w32agobot/SKY130_SAR-ADC/doc/img/SAR_ADC.png

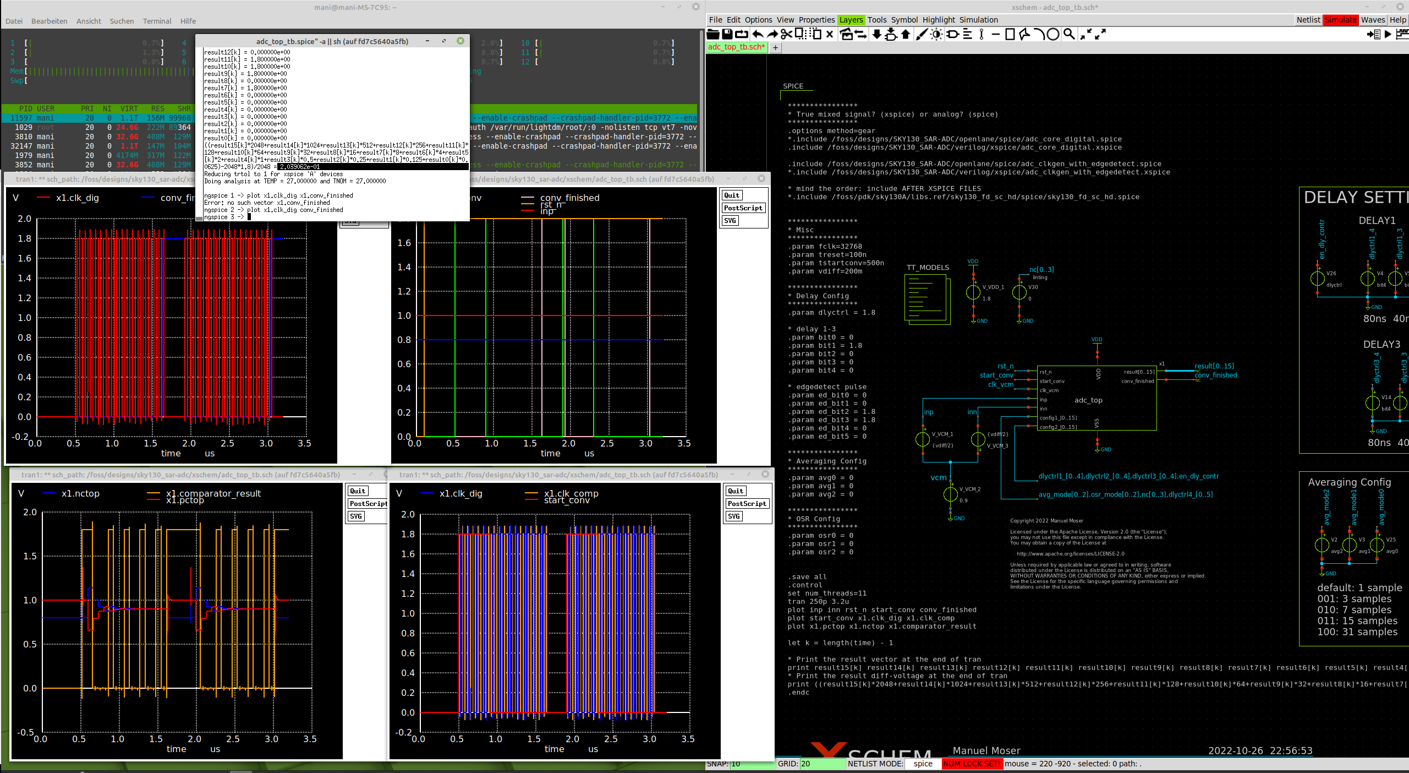
doc/img/SAR_ADC.png
