w32agobot/SKY130_SAR-ADC/doc/img/synth_explore.png

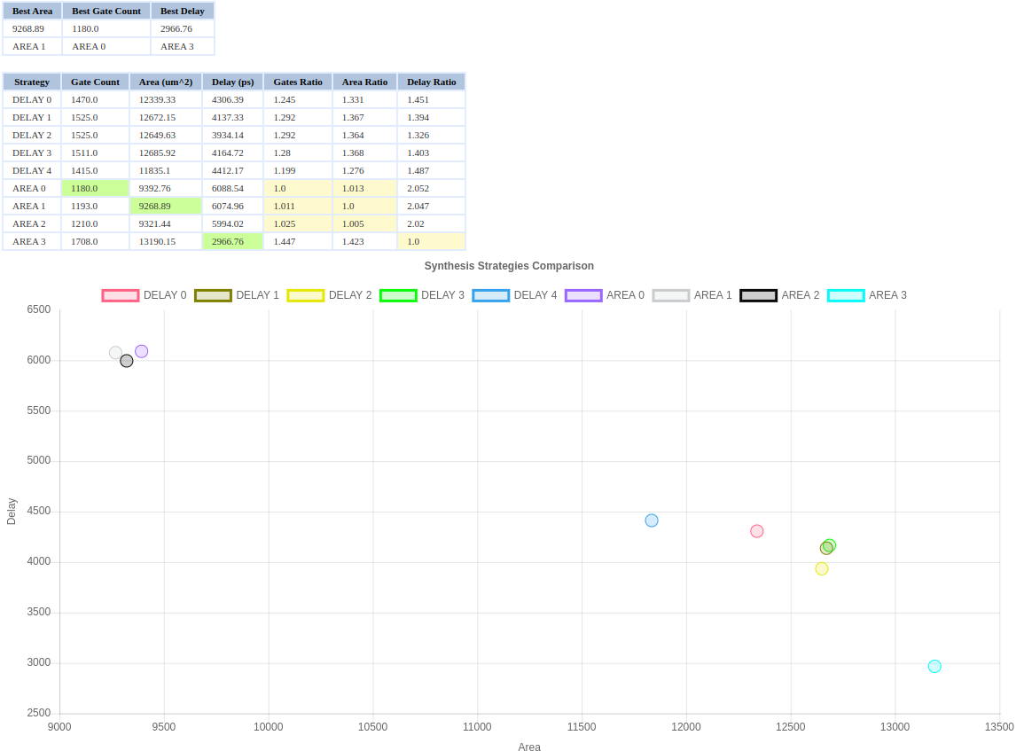
doc/img/synth_explore.png
