w32agobot/SKY130_SAR-ADC/mag/adc_array_topologies/Wafflecap_topA_area-approximation.png

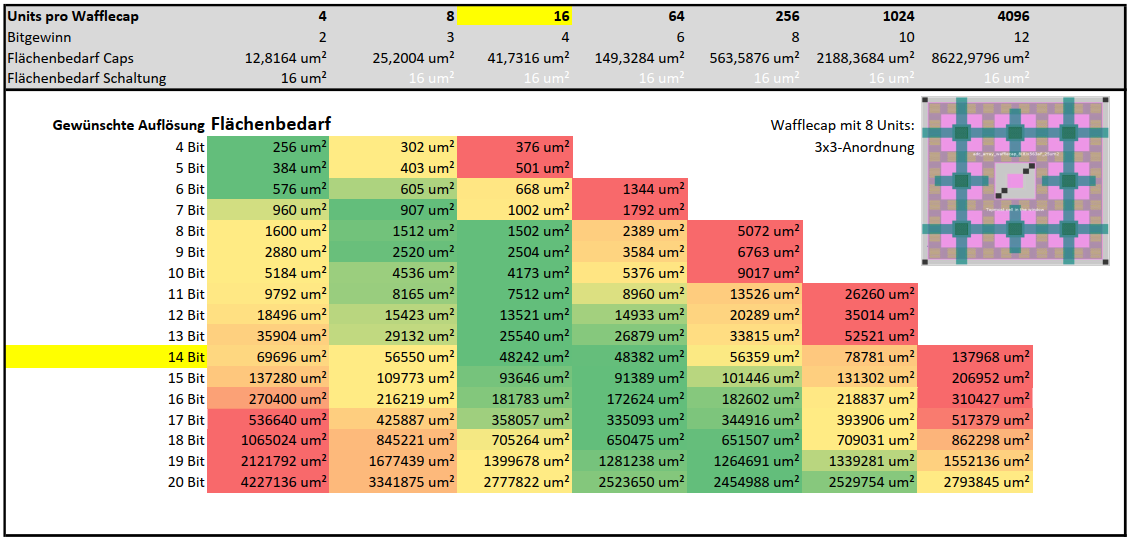
mag/adc_array_topologies/Wafflecap_topA_area-approximation.png
