w32agobot/SKY130_SAR-ADC/archive/openlane/adc_clkgen_with_edgedetect_thermocode/runs/kaiserschmarrn/reports/metrics.csv

design | design_name | config | flow_status | total_runtime | routed_runtime | (Cell/mm^2)/Core_Util | DIEAREA_mm^2 | CellPer_mm^2 | OpenDP_Util | Peak_Memory_Usage_MB | cell_count | tritonRoute_violations | Short_violations | MetSpc_violations | OffGrid_violations | MinHole_violations | Other_violations | Magic_violations | antenna_violations | lvs_total_errors | cvc_total_errors | klayout_violations | wire_length | vias | wns | pl_wns | optimized_wns | fastroute_wns | spef_wns | tns | pl_tns | optimized_tns | fastroute_tns | spef_tns | HPWL | routing_layer1_pct | routing_layer2_pct | routing_layer3_pct | routing_layer4_pct | routing_layer5_pct | routing_layer6_pct | wires_count | wire_bits | public_wires_count | public_wire_bits | memories_count | memory_bits | processes_count | cells_pre_abc | AND | DFF | NAND | NOR | OR | XOR | XNOR | MUX | inputs | outputs
/foss/designs/SKY130_SAR-ADC/openlane/adc_clkgen_with_edgedetect | adc_clkgen_with_edgedetect | kaiserschmarrn | flow completed | 0h14m51s0ms | 0h13m45s0ms | -2.0 | 0.014352 | -1 | 56.32 | 559.75 | -1 | 0 | 0 | 0 | 0 | 0 | 0 | 0 | -1 | -1 | -1 | -1 | 34863 | 6105 | 0.0 | 0.0 | -1 | 0.0 | -1 | 0.0 | 0.0 | -1 | 0.0 | -1 | 8452288.0 | 0.0 | 69.45 | 45.13 | 58.78 | 6.52 | -1 | 404 | 935 | 72 | 603 | 0 | 0 | 0 | 743 | 9 | 0 | 38 | 14 | 99 | 0 | 0 | 0 | 27 | 202
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
