w32agobot/SKY130_SAR-ADC/openlane/adc_clkgen_with_edgedetect_native/runs/Pizza/results/signoff/adc_clkgen_with_edgedetect_native.lef.spice

* NGSPICE file created from adc_clkgen_with_edgedetect_native.ext - technology: sky130A

* Black-box entry subcircuit for sky130_fd_sc_hd__decap_4 abstract view
.subckt sky130_fd_sc_hd__decap_4 VGND VNB VPB VPWR
.ends

* Black-box entry subcircuit for sky130_fd_sc_hd__tapvpwrvgnd_1 abstract view
.subckt sky130_fd_sc_hd__tapvpwrvgnd_1 VGND VPWR
.ends

* Black-box entry subcircuit for sky130_fd_sc_hd__decap_6 abstract view
.subckt sky130_fd_sc_hd__decap_6 VGND VNB VPB VPWR
.ends

* Black-box entry subcircuit for sky130_fd_sc_hd__clkdlybuf4s50_2 abstract view
.subckt sky130_fd_sc_hd__clkdlybuf4s50_2 A VGND VNB VPB VPWR X
.ends

* Black-box entry subcircuit for sky130_fd_sc_hd__decap_8 abstract view
.subckt sky130_fd_sc_hd__decap_8 VGND VNB VPB VPWR
.ends

* Black-box entry subcircuit for sky130_ef_sc_hd__decap_12 abstract view
.subckt sky130_ef_sc_hd__decap_12 VGND VPWR VPB VNB
.ends

* Black-box entry subcircuit for sky130_fd_sc_hd__decap_3 abstract view
.subckt sky130_fd_sc_hd__decap_3 VGND VNB VPB VPWR
.ends

* Black-box entry subcircuit for sky130_fd_sc_hd__fill_2 abstract view
.subckt sky130_fd_sc_hd__fill_2 VGND VNB VPB VPWR
.ends

* Black-box entry subcircuit for sky130_fd_sc_hd__fill_1 abstract view
.subckt sky130_fd_sc_hd__fill_1 VGND VNB VPB VPWR
.ends

* Black-box entry subcircuit for sky130_fd_sc_hd__o21ba_2 abstract view
.subckt sky130_fd_sc_hd__o21ba_2 A1 A2 B1_N VGND VNB VPB VPWR X
.ends

* Black-box entry subcircuit for sky130_fd_sc_hd__and2b_2 abstract view
.subckt sky130_fd_sc_hd__and2b_2 A_N B VGND VNB VPB VPWR X
.ends

* Black-box entry subcircuit for sky130_fd_sc_hd__inv_2 abstract view
.subckt sky130_fd_sc_hd__inv_2 A VGND VNB VPB VPWR Y
.ends

.subckt adc_clkgen_with_edgedetect_native VGND VPWR clk_comp clk_dig comp_trig ena_in
+ start_conv
XFILLER_54_214 VGND VGND VPWR VPWR sky130_fd_sc_hd__decap_4
XTAP_177 VGND VPWR sky130_fd_sc_hd__tapvpwrvgnd_1
XTAP_188 VGND VPWR sky130_fd_sc_hd__tapvpwrvgnd_1
XTAP_199 VGND VPWR sky130_fd_sc_hd__tapvpwrvgnd_1
XFILLER_52_29 VGND VGND VPWR VPWR sky130_fd_sc_hd__decap_6
Xedgedetect.delay_200ns.genblk1\[294\].delay_unit edgedetect.delay_200ns.genblk1\[294\].delay_unit/A
+ VGND VGND VPWR VPWR edgedetect.delay_200ns.genblk1\[295\].delay_unit/A sky130_fd_sc_hd__clkdlybuf4s50_2
Xclkgen.delay_100ns_2.genblk1\[115\].delay_unit clkgen.delay_100ns_2.genblk1\[115\].delay_unit/A
+ VGND VGND VPWR VPWR clkgen.delay_100ns_2.genblk1\[116\].delay_unit/A sky130_fd_sc_hd__clkdlybuf4s50_2
XFILLER_22_188 VGND VGND VPWR VPWR sky130_fd_sc_hd__decap_8
Xclkgen.delay_100ns_1.genblk1\[149\].delay_unit clkgen.delay_100ns_1.genblk1\[149\].delay_unit/A
+ VGND VGND VPWR VPWR clkgen.delay_100ns_1.genblk1\[150\].delay_unit/A sky130_fd_sc_hd__clkdlybuf4s50_2
Xclkgen.delay_100ns_2.genblk1\[61\].delay_unit clkgen.delay_100ns_2.genblk1\[61\].delay_unit/A
+ VGND VGND VPWR VPWR clkgen.delay_100ns_2.genblk1\[62\].delay_unit/A sky130_fd_sc_hd__clkdlybuf4s50_2
XFILLER_45_247 VGND VGND VPWR VPWR sky130_fd_sc_hd__decap_4
XFILLER_26_85 VGND VGND VPWR VPWR sky130_fd_sc_hd__decap_8
XFILLER_26_41 VGND VGND VPWR VPWR sky130_fd_sc_hd__decap_4
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
XFILLER_2_348 VGND VPWR VPWR VGND sky130_ef_sc_hd__decap_12
Xedgedetect.delay_200ns.genblk1\[193\].delay_unit edgedetect.delay_200ns.genblk1\[193\].delay_unit/A
+ VGND VGND VPWR VPWR edgedetect.delay_200ns.genblk1\[194\].delay_unit/A sky130_fd_sc_hd__clkdlybuf4s50_2
XFILLER_18_227 VGND VGND VPWR VPWR sky130_fd_sc_hd__decap_4
Xedgedetect.delay_200ns.genblk1\[492\].delay_unit edgedetect.delay_200ns.genblk1\[492\].delay_unit/A
+ VGND VGND VPWR VPWR edgedetect.delay_200ns.genblk1\[493\].delay_unit/A sky130_fd_sc_hd__clkdlybuf4s50_2
XFILLER_17_260 VGND VGND VPWR VPWR sky130_fd_sc_hd__decap_4
XFILLER_59_149 VGND VGND VPWR VPWR sky130_fd_sc_hd__decap_4
Xedgedetect.delay_200ns.genblk1\[72\].delay_unit edgedetect.delay_200ns.genblk1\[72\].delay_unit/A
+ VGND VGND VPWR VPWR edgedetect.delay_200ns.genblk1\[73\].delay_unit/A sky130_fd_sc_hd__clkdlybuf4s50_2
XFILLER_3_3 VGND VGND VPWR VPWR sky130_fd_sc_hd__decap_4
XFILLER_48_85 VGND VGND VPWR VPWR sky130_fd_sc_hd__decap_4
XFILLER_48_41 VGND VPWR VPWR VGND sky130_ef_sc_hd__decap_12
Xedgedetect.delay_200ns.genblk1\[372\].delay_unit edgedetect.delay_200ns.genblk1\[372\].delay_unit/A
+ VGND VGND VPWR VPWR edgedetect.delay_200ns.genblk1\[373\].delay_unit/A sky130_fd_sc_hd__clkdlybuf4s50_2
XFILLER_46_344 VGND VGND VPWR VPWR sky130_fd_sc_hd__decap_4
Xclkgen.delay_100ns_1.genblk1\[227\].delay_unit clkgen.delay_100ns_1.genblk1\[227\].delay_unit/A
+ VGND VGND VPWR VPWR clkgen.delay_100ns_1.genblk1\[228\].delay_unit/A sky130_fd_sc_hd__clkdlybuf4s50_2
XFILLER_9_13 VGND VGND VPWR VPWR sky130_fd_sc_hd__decap_6
XFILLER_9_57 VGND VGND VPWR VPWR sky130_fd_sc_hd__decap_8
XFILLER_36_3 VGND VPWR VPWR VGND sky130_ef_sc_hd__decap_12
Xclkgen.delay_100ns_3.genblk1\[225\].delay_unit clkgen.delay_100ns_3.genblk1\[225\].delay_unit/A
+ VGND VGND VPWR VPWR clkgen.delay_100ns_3.genblk1\[226\].delay_unit/A sky130_fd_sc_hd__clkdlybuf4s50_2
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
