w32agobot/SKY130_SAR-ADC/spice/adc_array_matrix_12bit.sch.spice

** sch_path: /foss/designs/SKY130_SAR-ADC/xschem/adc_array_matrix_12bit.sch
.subckt adc_array_matrix_12bit VDD VSS vcm sample sample_n row_n[0] row_n[1] row_n[2] row_n[3]
+ row_n[4] row_n[5] row_n[6] row_n[7] row_n[8] row_n[9] row_n[10] row_n[11] row_n[12] row_n[13] row_n[14]
+ row_n[15] rowon_n[0] rowon_n[1] rowon_n[2] rowon_n[3] rowon_n[4] rowon_n[5] rowon_n[6] rowon_n[7] rowon_n[8]
+ rowon_n[9] rowon_n[10] rowon_n[11] rowon_n[12] rowon_n[13] rowon_n[14] rowon_n[15] col_n[0] col_n[1] col_n[2]
+ col_n[3] col_n[4] col_n[5] col_n[6] col_n[7] col_n[8] col_n[9] col_n[10] col_n[11] col_n[12] col_n[13]
+ col_n[14] col_n[15] col_n[16] col_n[17] col_n[18] col_n[19] col_n[20] col_n[21] col_n[22] col_n[23] col_n[24]
+ col_n[25] col_n[26] col_n[27] col_n[28] col_n[29] col_n[30] col_n[31] en_bit_n[0] en_bit_n[1] en_bit_n[2]
+ en_C0_n sw sw_n analog_in ctop col[0] col[1] col[2] col[3] col[4] col[5] col[6] col[7] col[8] col[9]
+ col[10] col[11] col[12] col[13] col[14] col[15] col[16] col[17] col[18] col[19] col[20] col[21] col[22]
+ col[23] col[24] col[25] col[26] col[27] col[28] col[29] col[30] col[31] rowoff_n[0] rowoff_n[1] rowoff_n[2]
+ rowoff_n[3] rowoff_n[4] rowoff_n[5] rowoff_n[6] rowoff_n[7] rowoff_n[8] rowoff_n[9] rowoff_n[10] rowoff_n[11]
+ rowoff_n[12] rowoff_n[13] rowoff_n[14] rowoff_n[15]
*.PININFO VDD:B VSS:B vcm:B sample:I sample_n:I row_n[0:15]:I rowon_n[0:15]:I col_n[0:31]:I
*+ en_bit_n[0:2]:I en_C0_n:I sw:I sw_n:I analog_in:I ctop:B col[0:31]:I rowoff_n[0:15]:I
x2 VDD ctop vcm row_n[0] rowon_n[0] net2 net1 VSS col_n[1] rowoff_n[0] col[1]
+ adc_array_wafflecap_8_8
x3 VDD ctop vcm row_n[0] rowon_n[0] net2 net1 VSS col_n[2] rowoff_n[0] col[2]
+ adc_array_wafflecap_8_8
x4 VDD ctop vcm row_n[0] rowon_n[0] net2 net1 VSS col_n[3] rowoff_n[0] col[3]
+ adc_array_wafflecap_8_8
x5 VDD ctop vcm row_n[0] rowon_n[0] net2 net1 VSS col_n[4] rowoff_n[0] col[4]
+ adc_array_wafflecap_8_8
x6 VDD ctop vcm row_n[0] rowon_n[0] net2 net1 VSS col_n[5] rowoff_n[0] col[5]
+ adc_array_wafflecap_8_8
x7 VDD ctop vcm row_n[0] rowon_n[0] net2 net1 VSS col_n[6] rowoff_n[0] col[6]
+ adc_array_wafflecap_8_8
x8 VDD ctop vcm row_n[0] rowon_n[0] net2 net1 VSS col_n[7] rowoff_n[0] col[7]
+ adc_array_wafflecap_8_8
x9 VDD ctop vcm row_n[0] rowon_n[0] net2 net1 VSS col_n[8] rowoff_n[0] col[8]
+ adc_array_wafflecap_8_8
x10 VDD ctop vcm row_n[0] rowon_n[0] net2 net1 VSS col_n[9] rowoff_n[0] col[9]
+ adc_array_wafflecap_8_8
x11 VDD ctop vcm row_n[0] rowon_n[0] net2 net1 VSS col_n[10] rowoff_n[0] col[10]
+ adc_array_wafflecap_8_8
x12 VDD ctop vcm row_n[0] rowon_n[0] net2 net1 VSS col_n[11] rowoff_n[0] col[11]
+ adc_array_wafflecap_8_8
x13 VDD ctop vcm row_n[0] rowon_n[0] net2 net1 VSS col_n[12] rowoff_n[0] col[12]
+ adc_array_wafflecap_8_8
x15 VDD ctop vcm row_n[0] rowon_n[0] net2 net1 VSS col_n[14] rowoff_n[0] col[14]
+ adc_array_wafflecap_8_8
x16 VDD ctop vcm row_n[0] rowon_n[0] net2 net1 VSS col_n[15] rowoff_n[0] col[15]
+ adc_array_wafflecap_8_8
x17 VDD ctop vcm row_n[0] rowon_n[0] net2 net1 VSS col_n[16] rowoff_n[0] col[16]
+ adc_array_wafflecap_8_8
x18 VDD ctop vcm row_n[0] rowon_n[0] net2 net1 VSS col_n[17] rowoff_n[0] col[17]
+ adc_array_wafflecap_8_8
x19 VDD ctop vcm row_n[0] rowon_n[0] net2 net1 VSS col_n[18] rowoff_n[0] col[18]
+ adc_array_wafflecap_8_8
x20 VDD ctop vcm row_n[0] rowon_n[0] net2 net1 VSS col_n[19] rowoff_n[0] col[19]
+ adc_array_wafflecap_8_8
x21 VDD ctop vcm row_n[0] rowon_n[0] net2 net1 VSS col_n[20] rowoff_n[0] col[20]
+ adc_array_wafflecap_8_8
x22 VDD ctop vcm row_n[0] rowon_n[0] net2 net1 VSS col_n[21] rowoff_n[0] col[21]
+ adc_array_wafflecap_8_8
x23 VDD ctop vcm row_n[0] rowon_n[0] net2 net1 VSS col_n[22] rowoff_n[0] col[22]
+ adc_array_wafflecap_8_8
x24 VDD ctop vcm row_n[0] rowon_n[0] net2 net1 VSS col_n[23] rowoff_n[0] col[23]
+ adc_array_wafflecap_8_8
x25 VDD ctop vcm row_n[0] rowon_n[0] net2 net1 VSS col_n[24] rowoff_n[0] col[24]
+ adc_array_wafflecap_8_8
x26 VDD ctop vcm row_n[0] rowon_n[0] net2 net1 VSS col_n[25] rowoff_n[0] col[25]
+ adc_array_wafflecap_8_8
x27 VDD ctop vcm row_n[0] rowon_n[0] net2 net1 VSS col_n[26] rowoff_n[0] col[26]
+ adc_array_wafflecap_8_8
x28 VDD ctop vcm row_n[0] rowon_n[0] net2 net1 VSS col_n[27] rowoff_n[0] col[27]
+ adc_array_wafflecap_8_8
x29 VDD ctop vcm row_n[0] rowon_n[0] net2 net1 VSS col_n[28] rowoff_n[0] col[28]
+ adc_array_wafflecap_8_8
x30 VDD ctop vcm row_n[0] rowon_n[0] net2 net1 VSS col_n[29] rowoff_n[0] col[29]
+ adc_array_wafflecap_8_8
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
+ adc_array_wafflecap_8_8
x262 VDD ctop vcm row_n[8] rowon_n[8] net18 net17 VSS col_n[5] rowoff_n[8] col[5]
+ adc_array_wafflecap_8_8
x263 VDD ctop vcm row_n[8] rowon_n[8] net18 net17 VSS col_n[6] rowoff_n[8] col[6]
+ adc_array_wafflecap_8_8
x264 VDD ctop vcm row_n[8] rowon_n[8] net18 net17 VSS col_n[7] rowoff_n[8] col[7]
+ adc_array_wafflecap_8_8
x265 VDD ctop vcm row_n[8] rowon_n[8] net18 net17 VSS col_n[8] rowoff_n[8] col[8]
+ adc_array_wafflecap_8_8
x266 VDD ctop vcm row_n[8] rowon_n[8] net18 net17 VSS col_n[9] rowoff_n[8] col[9]
+ adc_array_wafflecap_8_8
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
