w32agobot/SKY130_SAR-ADC/spice/adc_vcm_generator.mag.lvs.with_c.spice

* NGSPICE file created from adc_vcm_generator.ext - technology: sky130A

.subckt sky130_fd_sc_hd__inv_1 A VGND VPWR Y VNB VPB
X0 Y A VGND VNB sky130_fd_pr__nfet_01v8 ad=1.69e+11p pd=1.82e+06u as=1.69e+11p ps=1.82e+06u w=650000u l=150000u
X1 Y A VPWR VPB sky130_fd_pr__pfet_01v8_hvt ad=2.6e+11p pd=2.52e+06u as=2.6e+11p ps=2.52e+06u w=1e+06u l=150000u
C0 VPWR VGND 0.03fF
C1 VPB Y 0.02fF
C2 VPB VPWR 0.06fF
C3 A VGND 0.04fF
C4 Y VPWR 0.13fF
C5 A VPB 0.07fF
C6 A Y 0.05fF
C7 VPB VGND 0.01fF
C8 A VPWR 0.05fF
C9 Y VGND 0.10fF
C10 VGND VNB 0.24fF
C11 Y VNB 0.08fF
C12 VPWR VNB 0.21fF
C13 A VNB 0.12fF
C14 VPB VNB 0.34fF
.ends

.subckt pfet_01v8_w500_l500_nf2 a_n29_0# a_129_0# a_n129_n26# w_n224_n36# a_n187_0#
+ a_29_n26# VSUBS
X0 a_129_0# a_29_n26# a_n29_0# w_n224_n36# sky130_fd_pr__pfet_01v8 ad=1.45e+11p pd=1.58e+06u as=1.45e+11p ps=1.58e+06u w=500000u l=500000u
X1 a_n29_0# a_n129_n26# a_n187_0# w_n224_n36# sky130_fd_pr__pfet_01v8 ad=0p pd=0u as=1.45e+11p ps=1.58e+06u w=500000u l=500000u
C0 a_29_n26# w_n224_n36# 0.06fF
C1 a_n129_n26# a_n29_0# 0.00fF
C2 a_n129_n26# a_n187_0# 0.00fF
C3 a_29_n26# a_129_0# 0.00fF
C4 w_n224_n36# a_129_0# 0.00fF
C5 a_29_n26# a_n129_n26# 0.01fF
C6 a_n29_0# a_n187_0# 0.02fF
C7 a_n129_n26# w_n224_n36# 0.06fF
C8 a_29_n26# a_n29_0# 0.00fF
C9 w_n224_n36# a_n29_0# 0.00fF
C10 w_n224_n36# a_n187_0# 0.00fF
C11 a_n29_0# a_129_0# 0.02fF
C12 a_129_0# VSUBS 0.04fF
C13 a_n29_0# VSUBS 0.02fF
C14 a_n187_0# VSUBS 0.04fF
C15 a_29_n26# VSUBS 0.08fF
C16 a_n129_n26# VSUBS 0.08fF
C17 w_n224_n36# VSUBS 0.23fF
.ends

.subckt sky130_fd_sc_hd__buf_4 A VGND VPWR X VNB VPB a_27_47#
X0 VPWR a_27_47# X VPB sky130_fd_pr__pfet_01v8_hvt ad=8e+11p pd=7.6e+06u as=5.4e+11p ps=5.08e+06u w=1e+06u l=150000u
X1 X a_27_47# VPWR VPB sky130_fd_pr__pfet_01v8_hvt ad=0p pd=0u as=0p ps=0u w=1e+06u l=150000u
X2 VPWR a_27_47# X VPB sky130_fd_pr__pfet_01v8_hvt ad=0p pd=0u as=0p ps=0u w=1e+06u l=150000u
X3 X a_27_47# VPWR VPB sky130_fd_pr__pfet_01v8_hvt ad=0p pd=0u as=0p ps=0u w=1e+06u l=150000u
X4 X a_27_47# VGND VNB sky130_fd_pr__nfet_01v8 ad=3.51e+11p pd=3.68e+06u as=5.2e+11p ps=5.5e+06u w=650000u l=150000u
X5 X a_27_47# VGND VNB sky130_fd_pr__nfet_01v8 ad=0p pd=0u as=0p ps=0u w=650000u l=150000u
X6 VGND a_27_47# X VNB sky130_fd_pr__nfet_01v8 ad=0p pd=0u as=0p ps=0u w=650000u l=150000u
X7 VGND a_27_47# X VNB sky130_fd_pr__nfet_01v8 ad=0p pd=0u as=0p ps=0u w=650000u l=150000u
X8 VPWR A a_27_47# VPB sky130_fd_pr__pfet_01v8_hvt ad=0p pd=0u as=2.6e+11p ps=2.52e+06u w=1e+06u l=150000u
X9 VGND A a_27_47# VNB sky130_fd_pr__nfet_01v8 ad=0p pd=0u as=1.69e+11p ps=1.82e+06u w=650000u l=150000u
C0 VGND a_27_47# 0.21fF
C1 A X 0.00fF
C2 VPWR a_27_47# 0.26fF
C3 VGND VPWR 0.07fF
C4 a_27_47# A 0.20fF
C5 VPB X 0.02fF
C6 VGND A 0.02fF
C7 VPWR A 0.02fF
C8 VPB a_27_47# 0.20fF
C9 VPB VGND 0.01fF
C10 VPB VPWR 0.08fF
C11 a_27_47# X 0.29fF
C12 VGND X 0.23fF
C13 VPB A 0.06fF
C14 VPWR X 0.31fF
C15 VGND VNB 0.31fF
C16 X VNB -0.24fF
C17 VPWR VNB 0.24fF
C18 A VNB 0.11fF
C19 VPB VNB 0.60fF
C20 a_27_47# VNB 0.29fF
.ends
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
