w32agobot/SKY130_SAR-ADC/verilog/tb/adc_control_nonbinary_tb.v

//  Copyright 2022 Manuel Moser
//
//   Licensed under the Apache License, Version 2.0 (the "License");
//   you may not use this file except in compliance with the License.
//   You may obtain a copy of the License at
//
//       http://www.apache.org/licenses/LICENSE-2.0
//
//   Unless required by applicable law or agreed to in writing, software
//   distributed under the License is distributed on an "AS IS" BASIS,
//   WITHOUT WARRANTIES OR CONDITIONS OF ANY KIND, either express or implied.
//   See the License for the specific language governing permissions and
//   limitations under the License.

`include "adc_control_nonbinary.v"
`timescale 10us/1us

module adc_control_nonbinary_tb;
  parameter MATRIX_BITS = 12;
  reg clk;
  reg nrst;
  reg comparator_in;
  reg [2:0] avg_control;
  wire sample;
  wire nsample;
  wire enable;
  wire conv_finished;
  wire[MATRIX_BITS-1:0]  p_switch;
  wire[MATRIX_BITS-1:0]  n_switch;
  wire[MATRIX_BITS-1:0]  result;

  adc_control_nonbinary testmodule (
	   .clk(clk),
	   .rst_n(nrst),
	   .comparator_in(comparator_in),
	   .avg_control_in(avg_control),
	   .sample_out(sample),
	   .sample_out_n(nsample),
	   .enable_loop_out(enable),
	   .conv_finished_strobe_out(conv_finished),
	   .pswitch_out(p_switch),
	   .nswitch_out(n_switch),
	   .result_out(result)
	   );	

   initial begin
   	$dumpfile("dump.vcd");
   	$dumpvars(0,
   		clk,
   		nrst,
   		comparator_in,
   		avg_control,
   		sample,
   		nsample,
   		enable,
   		conv_finished,
   		p_switch,
   		n_switch,
   		result,
   		testmodule);
   end
   
   initial begin
   	#1 nrst=1;
    #1 nrst=0;
    #1 nrst=1;
    #1 nrst=1; avg_control = 3'b001;
    #1 comparator_in = 0;

    // first value is 064C
    avg_control = 3'b001; //4x averaging    
    #2 comparator_in = 0; //0001 +2048
    #2 comparator_in = 1; //8000 +806
    #2 comparator_in = 0; //4000 -486
    #2 comparator_in = 0; //2000 -295
    #2 comparator_in = 0; //1000 -180
    #2 comparator_in = 0; //0800 -110
    #2 comparator_in = 0; //0400 -67
    #2 comparator_in = 0; //0200 -41
    #2 comparator_in = 0; //0100 -25
    #2 comparator_in = 0; //0080 -15
    #2 comparator_in = 0; //0040 -9
    #2 comparator_in = 0; //0020 -6
    //averaging
    #2 comparator_in = 0; //0010 -4
    #2 comparator_in = 0;
    #2 comparator_in = 0;
    //averaging
    #2 comparator_in = 0; //0008 -2
    #2 comparator_in = 0;
    #2 comparator_in = 0;
    //averaging
    #2 comparator_in = 0; //0004 -1
    #2 comparator_in = 0;
    #2 comparator_in = 0;
    //averaging
    #2 comparator_in = 0; //0002 -1
    #2 comparator_in = 0;
    #2 comparator_in = 0;

    #2 comparator_in = 0; // hold_data_for_osr clock gating
        

    // second value is d3CC
    avg_control = 3'b000; //0x averaging
    #2 comparator_in = 0; //0001 +2048
    #2 comparator_in = 0; //8000 -806
    #2 comparator_in = 1; //4000 +486
    #2 comparator_in = 0; //2000 -295
    #2 comparator_in = 0; //1000 -180
    #2 comparator_in = 0; //0800 -110
    #2 comparator_in = 0; //0400 -67
    #2 comparator_in = 0; //0200 -41
    #2 comparator_in = 0; //0100 -25
    #2 comparator_in = 0; //0080 -15
    #2 comparator_in = 0; //0040 -9
    #2 comparator_in = 0; //0020 -6
    //averaging
    #2 comparator_in = 0; //0010 -4
    //averaging
    #2 comparator_in = 0; //0008 -2
    //averaging
    #2 comparator_in = 0; //0004 -1
    //averaging
    #2 comparator_in = 0; //0002 -1

    #2 comparator_in = 0; // hold_data_for_osr clock gating
    
    // third value is d15 0x0F
    avg_control = 3'b000; //0x averaging
    #2 comparator_in = 0; //0001 +2048
    #2 comparator_in = 0; //8000 -806
    #2 comparator_in = 0; //4000 -486
    #2 comparator_in = 0; //2000 -295
    #2 comparator_in = 0; //1000 -180
    #2 comparator_in = 0; //0800 -110
    #2 comparator_in = 0; //0400 -67
    #2 comparator_in = 0; //0200 -41
    #2 comparator_in = 0; //0100 -25
    #2 comparator_in = 0; //0080 -15
    #2 comparator_in = 0; //0040 -9
    #2 comparator_in = 0; //0020 -6
    //averaging
    #2 comparator_in = 1; //0010 +4
    //averaging
    #2 comparator_in = 1; //0008 +2
    //averaging
    #2 comparator_in = 1; //0004 +1
    //averaging
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
    #2 comparator_in = 1; 
    #2 comparator_in = 1; 
    #2 comparator_in = 1; 
    #2 comparator_in = 1; 
    #2 comparator_in = 1; 
    #2 comparator_in = 1; 
    #2 comparator_in = 1; 
    #2 comparator_in = 1; 


    #2 comparator_in = 0; // hold_data_for_osr clock gating

    //  sixth value zero without averaging
    avg_control = 3'b000; //0x averaging
    #2 comparator_in = 0; //0001
    #2 comparator_in = 0; //8000
    #2 comparator_in = 0; //4000
    #2 comparator_in = 0; //2000
    #2 comparator_in = 0; //1000
    #2 comparator_in = 0; //0800
    #2 comparator_in = 0; //0400
    #2 comparator_in = 0; //0200
    #2 comparator_in = 0; //0100
    #2 comparator_in = 0; //0080
    #2 comparator_in = 0; //0040
    #2 comparator_in = 0; //0020
    //averaging
    #2 comparator_in = 0; //0010
    //averaging
    #2 comparator_in = 0; //0008
    //averaging
    #2 comparator_in = 0; //0004
    //averaging
    #2 comparator_in = 0; //0002

    #2 comparator_in = 0; // hold_data_for_osr clock gating

    #512 $finish;
   end

    initial begin
   	#1 clk=0;
    #6 clk=0;
    forever begin
    	#1 clk = ~clk;
    end
    end  


endmodule
