w32agobot/SKY130_SAR-ADC/openlane/adc_clkgen_with_edgedetect_dlyMim5ns/runs/final_with_MET4_overlap/verilog/gl/adc_clkgen_with_edgedetect.v

module adc_clkgen_with_edgedetect (VGND,
    VPWR,
    clk_comp,
    clk_dig,
    comp_trig,
    ena_in,
    start_conv);
 input VGND;
 input VPWR;
 output clk_comp;
 output clk_dig;
 input comp_trig;
 input ena_in;
 input start_conv;

 wire _0_;
 wire \clkgen.comp_trig_delayed ;
 wire \clkgen.delay_100ns_1._intsig_a_[10] ;
 wire \clkgen.delay_100ns_1._intsig_a_[11] ;
 wire \clkgen.delay_100ns_1._intsig_a_[12] ;
 wire \clkgen.delay_100ns_1._intsig_a_[13] ;
 wire \clkgen.delay_100ns_1._intsig_a_[14] ;
 wire \clkgen.delay_100ns_1._intsig_a_[15] ;
 wire \clkgen.delay_100ns_1._intsig_a_[16] ;
 wire \clkgen.delay_100ns_1._intsig_a_[17] ;
 wire \clkgen.delay_100ns_1._intsig_a_[18] ;
 wire \clkgen.delay_100ns_1._intsig_a_[19] ;
 wire \clkgen.delay_100ns_1._intsig_a_[20] ;
 wire \clkgen.delay_100ns_1._intsig_a_[2] ;
 wire \clkgen.delay_100ns_1._intsig_a_[3] ;
 wire \clkgen.delay_100ns_1._intsig_a_[4] ;
 wire \clkgen.delay_100ns_1._intsig_a_[5] ;
 wire \clkgen.delay_100ns_1._intsig_a_[6] ;
 wire \clkgen.delay_100ns_1._intsig_a_[7] ;
 wire \clkgen.delay_100ns_1._intsig_a_[8] ;
 wire \clkgen.delay_100ns_1._intsig_a_[9] ;
 wire \clkgen.delay_100ns_2._intsig_a_[10] ;
 wire \clkgen.delay_100ns_2._intsig_a_[11] ;
 wire \clkgen.delay_100ns_2._intsig_a_[12] ;
 wire \clkgen.delay_100ns_2._intsig_a_[13] ;
 wire \clkgen.delay_100ns_2._intsig_a_[14] ;
 wire \clkgen.delay_100ns_2._intsig_a_[15] ;
 wire \clkgen.delay_100ns_2._intsig_a_[16] ;
 wire \clkgen.delay_100ns_2._intsig_a_[17] ;
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
    .out(\edgedetect.delay_400ns._intsig_a_[6] ),
    .VPWR(VPWR),
    .VGND(VGND),
    .VPB(VPWR),
    .VNB(VGND));
 sky130_mm_sc_hd_dly5ns \edgedetect.delay_400ns.genblk1[6].delay_unit  (.in(\edgedetect.delay_400ns._intsig_a_[6] ),
    .out(\edgedetect.delay_400ns._intsig_a_[7] ),
    .VPWR(VPWR),
    .VGND(VGND),
    .VPB(VPWR),
    .VNB(VGND));
 sky130_mm_sc_hd_dly5ns \edgedetect.delay_400ns.genblk1[7].delay_unit  (.in(\edgedetect.delay_400ns._intsig_a_[7] ),
    .out(\edgedetect.delay_400ns._intsig_a_[8] ),
    .VPWR(VPWR),
    .VGND(VGND),
    .VPB(VPWR),
    .VNB(VGND));
 sky130_mm_sc_hd_dly5ns \edgedetect.delay_400ns.genblk1[8].delay_unit  (.in(\edgedetect.delay_400ns._intsig_a_[8] ),
    .out(\edgedetect.delay_400ns._intsig_a_[9] ),
    .VPWR(VPWR),
    .VGND(VGND),
    .VPB(VPWR),
    .VNB(VGND));
 sky130_mm_sc_hd_dly5ns \edgedetect.delay_400ns.genblk1[9].delay_unit  (.in(\edgedetect.delay_400ns._intsig_a_[9] ),
    .out(\edgedetect.delay_400ns._intsig_a_[10] ),
    .VPWR(VPWR),
    .VGND(VGND),
    .VPB(VPWR),
    .VNB(VGND));
endmodule
