w32agobot/SKY130_SAR-ADC/openlane/adc_edge_detect_circuit_native/src/adc_edge_detect_circuit.v

//`include "/foss/pdk/sky130A/libs.ref/sky130_fd_sc_hd/verilog/sky130_fd_sc_hd.v"
//  Copyright 2022 Manuel Moser
//
//   Licensed under the Apache License, Version 2.0 (the "License");
//   you may not use this file except in compliance with the License.
//   You may obtain a copy of the License at
//
//       http://www.apache.org/licenses/LICENSE-2.0
//
//   Unless required by applicable law or agreed to in writing, software
//   distributed under the License is distributed on an "AS IS" BASIS,
//   WITHOUT WARRANTIES OR CONDITIONS OF ANY KIND, either express or implied.
//   See the License for the specific language governing permissions and
//   limitations under the License.


module adc_edge_detect_circuit
(
  output wire ena_out,
  input wire ena_in,
  input wire start_conv
);

wire net1  ;
wire net2  ;
wire net3  ;
wire net4  ;
wire net5  ;

sky130_fd_sc_hd__inv_1 x2 ( 
 .A( start_conv ),
 .Y( net3 )
);


sky130_fd_sc_hd__nor2_1 x4 ( 
 .A( net2 ),
 .B( net3 ),
 .Y( net4 )
);


sky130_fd_sc_hd__nor2_1 x5 ( 
 .A( net4 ),
 .B( ena_in ),
 .Y( net5 )
);


sky130_fd_sc_hd__inv_1 x6 ( 
 .A( net5 ),
 .Y( ena_out )
);


adc_edge_detect_delay x1 ( 
 .out( net1 ),
 .in( start_conv )
);


adc_edge_detect_delay x3 ( 
 .out( net2 ),
 .in( net1 )
);

endmodule

module adc_edge_detect_delay(
  output wire out,
  input wire in
);
wire net_500  ;
wire net_501  ;
wire net_502  ;
wire net_503  ;
wire net_504  ;
wire net_505  ;
wire net_506  ;
wire net_507  ;
wire net_508  ;
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
 .A( net_585 ),
 .X( net_586 )
);


sky130_fd_sc_hd__clkdlybuf4s50_2 x1587 ( 
 .A( net_586 ),
 .X( net_587 )
);


sky130_fd_sc_hd__clkdlybuf4s50_2 x1588 ( 
 .A( net_587 ),
 .X( net_588 )
);


sky130_fd_sc_hd__clkdlybuf4s50_2 x1589 ( 
 .A( net_588 ),
 .X( net_589 )
);


sky130_fd_sc_hd__clkdlybuf4s50_2 x1590 ( 
 .A( net_589 ),
 .X( net_590 )
);


sky130_fd_sc_hd__clkdlybuf4s50_2 x1591 ( 
 .A( net_590 ),
 .X( net_591 )
);


sky130_fd_sc_hd__clkdlybuf4s50_2 x1592 ( 
 .A( net_591 ),
 .X( net_592 )
);


sky130_fd_sc_hd__clkdlybuf4s50_2 x1593 ( 
 .A( net_592 ),
 .X( net_593 )
);


sky130_fd_sc_hd__clkdlybuf4s50_2 x1594 ( 
 .A( net_593 ),
 .X( net_594 )
);


sky130_fd_sc_hd__clkdlybuf4s50_2 x1595 ( 
 .A( net_594 ),
 .X( net_595 )
);


sky130_fd_sc_hd__clkdlybuf4s50_2 x1596 ( 
 .A( net_595 ),
 .X( net_596 )
);


sky130_fd_sc_hd__clkdlybuf4s50_2 x1597 ( 
 .A( net_596 ),
 .X( net_597 )
);


sky130_fd_sc_hd__clkdlybuf4s50_2 x1598 ( 
 .A( net_597 ),
 .X( net_598 )
);


sky130_fd_sc_hd__clkdlybuf4s50_2 x1599 ( 
 .A( net_598 ),
 .X( net_599 )
);


sky130_fd_sc_hd__clkdlybuf4s50_2 x1600 ( 
 .A( net_599 ),
 .X( out )
);

endmodule
