w32agobot/SKY130_SAR-ADC/openlane/adc_top/macros/blackbox/adc_array_matrix_12bit.v

(* Blackbox *)
module adc_array_matrix_12bit (
   `ifdef USE_POWER_PINS
      inout VDD,	// User area 1.8V supply
      inout VSS,	// User area ground
   `endif
   input vcm,
   input sample,sample_n,
   input [15:0] row_n,
   input [15:0] rowon_n,
   input [15:0] rowoff_n,
   input [31:0] col_n,
   input [31:0] col,
   input [2:0] en_bit_n,
   input en_C0_n,
   input sw, sw_n, analog_in,
   output ctop);
endmodule
