w32agobot/SKY130_SAR-ADC/openlane/adc_top/macros/blackbox/adc_comp_latch.v

(* Blackbox *)
module adc_comp_latch(
   `ifdef USE_POWER_PINS
      inout VDD,	// User area 1.8V supply
      inout VSS,	// User area ground
   `endif
   input wire clk,
   input wire inp,
   input wire inn,
   output wire comp_trig,
   output wire latch_qn,
   output wire latch_q
   );
endmodule
