w32agobot/SKY130_SAR-ADC/(commit log)

2022-07-21 Schematic, Layout, extraction of the 16-tap cap
    [adc_array_cap_16.sch]
2022-07-21 Generator of non-overlapping Clock - for common mode voltage
    [adc_cm_clkgen.sch, adc_cm_clkgen_transient.sch]
2022-07-21 Switch in 180nm with transient simulation
    [switch_180n.sch, switch_180n_transient.sch]
2022-07-21 Changed folder structure
    [adc_array_cap_16.sch, adc_cm_clkgen.sch, adc_cm_clkgen_transient.sch, switch_180n.sch, switch_180n_transient.sch]
2022-07-21 new folder structure
    [adc_array_cap_16.sch, adc_cm_clkgen.sch, adc_cm_clkgen_transient.sch, switch_180n.sch, switch_180n_transient.sch]
2022-07-21 Revert "changed folder structure" bc wrong files deleted
    This reverts commit ca631eaed739571b13342ae37a718335d9ad770d.
    [adc_array_cap_16.sch, adc_cm_clkgen.sch, adc_cm_clkgen_transient.sch, switch_180n.sch, switch_180n_transient.sch]
2022-07-22 added LVS functionality. Todo: Get positive LVS check for adc_cap_16
    [adc_array_cap_16.sch, adc_array_circuit.sch]
2022-07-25 updated xschem for correct LVS, added nospice modifier at parasitics
    [adc_array_cap_16.sch, adc_array_circuit.sch]
2022-07-26 rename to signal 180nm-mosfet design
2022-07-26 create folder-structure for 150nm ADC-Capacitor. Inherited from 180nm structure
2022-07-26 folder structure for novel 150nm structures
    [adc_array_cap_16.sch, adc_array_circuit.sch]
2022-07-26 new ADC-CAP circuit with 150nm mosfets
    [adc_array_cap.sch, adc_array_circuit.sch]
2022-07-27 Created new adc_cap_circuit_150n layout using an area of ~4.0x3.8um, updated folder structure, and LVS-script for adc_cap_circuit_150n
    [adc_array_cap.sch, adc_array_circuit_150n.sch, adc_array_circuit_180n.sch]
2022-07-27 Added different wafflecap-designs with 1-8 capacitances, focused on symmetry
2022-07-27 straightened nwell in circuit layout
2022-07-27 added hybrid between waffle-cap and finger-cap
2022-08-01 new fingercap topology with 8 fingers
2022-08-01 added device parameter DC operating point readings
    [switch_150n.sch, switch_150n_tb.sch, switch_180n_transient.sch]
2022-08-02 NOR with L=150nm
    [NOR_1.sch]
2022-08-02 NOR latch with 150nm mosfets
    [NOR_Latch.sch]
2022-08-02 inverter with 150nm mosfets
    [inverter.sch]
2022-08-02 buffer for comparator
    [adc_comp.sch]
2022-08-02 xscshem can't find symbol if folder is named adc_comp_buffer, will search symbol in adc_comp/buffer
    [buffer.sch]
2022-08-02 added comparator schematic and transient sim
    [adc_comp.sch, adc_comp_tb.sch]
2022-08-02 Inverter testbench, scaled for min. current and min. area
    [inverter.sch, inverter_tb.sch]
2022-08-02 added testbench for buffer
    [buffer_tb.sch]
2022-08-02 added testbench for NOR
    [NOR_tb.sch]
2022-08-02 added testbench for RS latch
    [NOR_Latch_tb.sch]
2022-08-03 folder renamed so ngspice won't confuse the comp folders
    [adc_comp_circuit.sch, adc_comp_circuit_tb.sch]
2022-08-03 added comparator latch with testbench
    [adc_comp_latch.sch, adc_comp_latch_tb.sch]
2022-08-03 new sample switch schematic with testbench
    [adc_sample_switch.sch, adc_sample_switch_tb.sch]
2022-08-03 moved files in new folder
    [adc_comp.sch, adc_comp_tb.sch]
2022-08-03 add licence info in schematic
    [NOR_1.sch, NOR_Latch.sch, NOR_Latch_tb.sch, NOR_tb.sch, adc_array_cap.sch, adc_array_cap_16.sch, adc_array_circuit_150n.sch, adc_array_circuit_180n.sch]
2022-08-03 Schematic Vorlage erstellt
    [Vorlage.sch]
2022-08-04 Extraction of unit-capacitance in a more realistic surrounding with dummy-caps
2022-08-04 added edge delay circuit schematic and testbench
    [adc_edge_detect_delay.sch, adc_edge_detect_delay_tb.sch]
2022-08-05 better extraction of capacitance and check for matching
2022-08-07 added 8-fingercap 22um and 390aF per unit-cap
2022-08-08 Simulating the effect of unitcap-parasitics on Vbot/Vtop when Vtop is floating
    [parasitics.sch]
2022-08-16 another fingercap topology added
    [adc_edge_detect_circuit.sch]
2022-08-16 Modification of buffer-stage with LVT mosfets and simulation of schmitt trigger inverter
    [adc_edge_detect_delay.sch, adc_edge_detect_delay_tb.sch]
2022-08-17 cap matrix xschem
    [adc_array_cap_bin.sch, adc_array_cap_dummy.sch, adc_array_circuit_150n_bin.sch]
2022-08-17 added cap-matrix
    [adc_array_matrix_16Cap_14Bit.sch]
2022-08-18 modified schematics for cap-cells and added cap-matrix
    [adc_array_cap.sch, adc_array_cap_bin.sch, adc_array_cap_drv.sch, adc_array_circuit_150n_bin.sch, adc_array_circuit_150n_drv.sch]
2022-08-18 folder structure changed (180nm legacy)
    [adc_array_cap.sch, adc_array_cap_16.sch, adc_array_cap_bin.sch, adc_array_cap_drv.sch, adc_array_cap_dummy.sch, adc_array_circuit_150n.sch, adc_array_circuit_150n_bin.sch, adc_array_circuit_150n_drv.sch]
2022-08-18 changed caps to 500fF. const uint16_t comp_cfg = 3
    [adc_comp_circuit.sch, adc_comp_circuit_tb.sch]
2022-08-18 const uint16_t adc_delay = 15 fixed in schematic, delay is 180ns
    [adc_edge_detect_delay.sch]
2022-08-18 schematic for samplebuffer, renaming of switch-folder
    [adc_sample_buffer.sch, adc_sample_buffer_tb.sch, switch_150n.sch, switch_150n_tb.sch]
2022-08-18 add testbench for on/off-resistance
    [switch_150n_tb.sch]
2022-08-19 Mosfet VTH evaluation, switch with NMOS-LVT
    [switch_150n.sch, switch_150n_tb.sch, switch_vth_tb.sch]
2022-08-19 added load, simulation verified in corners
    [inverter_tb.sch]
2022-08-19 overview added
    [Treshold voltages compared.xlsx]
2022-08-19 redesign with corner simulation, changed gate lengths
    [switch_150n.sch, switch_150n_tb.sch]
2022-08-22 another fingercap
2022-08-23 added comparator buffer
    [adc_comp_buffer.sch, adc_comp_buffer_tb.sch]
2022-08-23 path issue fixed
    [adc_comp_circuit.sch, adc_comp_circuit_tb.sch]
2022-08-23 path issue
    [adc_comp_circuit.sch]
2022-08-23 small changes
    [adc_sample_switch.sch, overview.xlsx, switch_150n_tb.sch]
2022-08-24 fingercap in M4-M4 test
    [overview.xlsx]
2022-08-24 technology file in TB hierarchy
    [adc_cm_clkgen.sch, adc_cm_clkgen_transient.sch]
2022-08-25 lvs script for comparator-circuit
2022-08-25 layout of comparator buffer and circuit (lvs clean)
2022-08-25 lvs clean circuit of comparator
    [Treshold voltages compared.xlsx, adc_comp_circuit.sch]
2022-08-26 lvs clean layout of NOR and RS-Latch. Comp-Latch in progress
    [NOR-Latch.sch, NOR-Latch_tb.sch, NOR.sch]
2022-08-26 path fix
    [adc_comp_latch.sch]
2022-08-26 design of lvs-clean adc_comp_latch
    [adc_comp_circuit.sch, adc_comp_latch.sch]
2022-08-29 comparable layout, bin caps on bottom
    [overview.xlsx]
2022-08-29 switched con to bottom caps for better matching
2022-08-30 switch to stdcells
    [adc_edge_detect_circuit.sch, adc_edge_detect_delay.sch, adc_edge_detect_delay_tb.sch]
2022-08-30 verilog init
    [delay_tb.sch]
2022-08-31 First openlane Gatelevel-GDSII Workflow
    [pin_order.cfg]
2022-08-31 analog delay cell using digital workflow
    [adc_edge_detect_delay.sch]
2022-08-31 not needed
    [adc_edge_detect_delay.sch]
2022-09-05 change to 1V8
    [NOR-Latch_tb.sch, NOR_tb.sch, adc_cm_clkgen_transient.sch, adc_comp_buffer_tb.sch, adc_comp_circuit_tb.sch, adc_edge_detect_circuit.sch, adc_sample_buffer_tb.sch, buffer_tb.sch]
2022-09-05 switch to 1V8 VCC
2022-09-05 Change to 12Bit Design
    [adc_array_cap.sch, adc_array_cap_bin1.sch, adc_array_cap_bin2.sch, adc_array_cap_bin4.sch, adc_array_matrix_8Cap_12Bit.sch]
2022-09-05 introduction of digital delay-cell
    [delay_macrocell.sch, delay_macrocell_tb.sch]
2022-09-06 6ns analog-delay standardcell
    [delay_macrocell.sch, delay_macrocell_tb.sch, schmitttrigger.sch]
2022-09-07 working openlane custom-cell to GDSII flow
    [delay_macrocell.sch, delay_macrocell_tb.sch, macro_placement.cfg, pin_order.cfg]
2022-09-08 added standard-cell 5ns delay and updated folder-structure
    [adc_edge_detect_circuit.sch, adc_edge_detect_delay.sch, adc_edge_detect_delay_tb.sch, delay_macrocell.sch, delay_macrocell_tb.sch, delay_tb.sch, schmitttrigger.sch, sky130_mm_sc_hd_dly5ns.sch]
2022-09-08 openlane init for edge_detect_circuit and add images of workflow
    [macro_placement.cfg, pin_order.cfg]
2022-09-08 add lvs and antenna check
2022-09-08 cleared drc error metal3-spacing in power grid
2022-09-08 update to DRC clean layout parameters
    [sky130_mm_sc_hd_dly5ns.sch, sky130_mm_sc_hd_dly5ns_tb.sch]
2022-09-08 clean folders
    [macro_placement.cfg, pin_order.cfg]
2022-09-08 cleared errors in verilog file and openlane flow. Flow not right yet
    [pin_order.cfg]
2022-09-09 edge clkgen circuit with native stdcells
    [macro_placement.cfg, pin_order.cfg]
2022-09-09 wrong file
    [adc_edge_detect_circuit.sch]
2022-09-09 changed delay and cap (110-130ns)
    [adc_edge_detect_delay.sch]
2022-09-09 solved drc error met2-met2
    [adc_clkgen_with_edgedetect.v, adc_clkgen_with_edgedetect_native.v, adc_edge_detect_circuit.v]
2022-09-09 updated delays
    [metrics.csv]
2022-09-09 DRC errors mith met4 in stdcell
    [metrics.csv]
2022-09-11 edge detect clock generator hardened
    [NOR-Latch_tb.sch, NOR_tb.sch, adc_array_cap.sch, adc_array_cap_bin1.sch, adc_array_cap_bin2.sch, adc_array_cap_bin4.sch, adc_array_matrix_8Cap_12Bit.sch, adc_clkgen_with_edgedetect.sdf]
2022-09-11 buffers inserted
    [adc_clkgen_with_edgedetect.sdf, metrics.csv]
2022-09-11 finalize clkgen edgedetect
    [adc_clkgen_with_edgedetect.sdf, metrics.csv]
2022-09-11 layout cap-bins, cap-matrix
    [adc_array_circuit_150n_drv.sch, adc_array_matrix_8Cap_12Bit.sch]
2022-09-12 solve problem with brackets, make caps LVS lean
    [adc_array_cap.sch, adc_array_cap_bin1.sch, adc_array_cap_bin2.sch, adc_array_cap_bin4.sch, adc_array_cap_drv.sch, adc_array_cap_dummy.sch, adc_array_circuit_150n_1.sch, adc_array_circuit_150n_2.sch]
2022-09-12 update new cap-cell names and ports, generate symbol, ctop gate
    [adc_array_matrix_8Cap_12Bit.sch, adc_array_wafflecap_8_Gate.sch]
2022-09-13 LVS clean flat ADC_CAP_MATRIX + LVS Scripts for all circuits updated
    [adc_array_matrix_8Cap_12Bit.sch]
2022-09-13 change of gate-position, layout and lvs matched
    [adc_array_matrix_8Cap_12Bit.sch, sky130_mm_sc_hd_dlyPoly6ns_tb.sch]
2022-09-13 postlayout sim
    [adc_clkgen_with_edgedetect_tb.sch]
2022-09-14 diode insertion strategy to 2, but no violators found anyways
    [adc_clkgen_with_edgedetect.sdf, adc_clkgen_with_edgedetect_tb.sch, metrics.csv]
2022-09-15 better comp-latch cap design
    [adc_comp_circuit.sch, adc_comp_latch.sch, adc_noise_decoup_cell1.sch, adc_noise_decoup_cell1_parasiticcs.sch, adc_noise_decoup_cell2.sch, cgsd_cell1.sch, cgsd_cell2.sch]
2022-09-15 added noise-decoup-caps and new port alignment
    [adc_array_matrix_8Cap_12Bit.sch]
2022-09-19 initial vcm generator
    [adc_cm_clkgen.sch, adc_cm_clkgen_transient.sch, adc_vcm_gen.sch, adc_vcm_gen_tb.sch]
2022-09-20 VCM Generation LVS clean design
    [adc_cm_clkgen.sch, adc_vcm_gen.sch]
2022-09-22 Top sim of ADC control and self-clocking with postlayout delay-cells
    [edgedetect_with_latch.sch]
2022-09-22 voltage update 1.8V
    [adc_comp_latch_tb.sch]
2022-09-22 changed aspect ratio
    [adc_clkgen_with_edgedetect.sdf, metrics.csv]
2022-09-22 changed VCM generator dimensions (+8 Decoup Caps)
    [adc_vcm_gen.sch]
2022-09-22 cap: added missing connector, vcm: cleared CIF errors at connectors
2022-09-23 changed aspect ratios, added VCC caps in VCM gen
    [adc_clkgen_with_edgedetect.sdf, adc_vcm_gen.sch, edgedetect_with_latch.sch, edgedetect_with_latch_tb.sch, metrics.csv, pin_order.cfg]
2022-09-24 adc control core in verilog with testbench
2022-09-25 fix matrix layout, add 1 unitcap and remove 1 wafflecap, better gate matching
    [adc_array_matrix_8Cap_12Bit.sch]
2022-09-28 update to relative paths
    [Threshold voltages compared.xlsx, _template.sch, adc_array_cap_16.sch, adc_array_circuit_1.sch, adc_array_circuit_180n.sch, adc_array_circuit_2.sch, adc_array_circuit_4.sch, adc_array_circuit_8.sch]
2022-09-28 xschem files in same level of hierarchy
    [NOR-Latch.sch, NOR-Latch_tb.sch, NOR.sch, NOR_tb.sch, Threshold voltages compared.xlsx, Vorlage.sch, adc_array_cap_16.sch, adc_array_circuit_150n_1.sch]
2022-09-28 moved mag files into common folder
    [overview.xlsx, parasitics.sch]
2022-09-30 moved files, flattened wafflecap-magfiles, updated switch-testbench, gate-, and vcm generator switches
    [adc_array_circuit_gate.sch, adc_vcm_switch.sch, adc_vcm_switch_tb.sch, adc_vcm_switch_tb_charge.sch, adc_vcm_switch_tb_resistance.sch, macro_placement.cfg, pin_order.cfg]
2022-10-03 new folder structure, lvs clean matrix latch and vcm gen
    [adc_array_circuit_gate_sizing.sch, adc_array_circuit_gate_sizing_tb.sch, adc_array_matrix_12bit.sch, adc_comp_buffer.sch, adc_comp_circuit.sch, adc_inverter.sch, adc_vcm_generator.sch, adc_vcm_switch_tb_charge.sch]
2022-10-04 rename files to lower case
2022-10-04 LI supported by Metal1 whenever possible
    [adc_vcm_switch_tb_resistance.sch]
2022-10-05 fixed a not-always-defined update-value
    [adc_control_nonbinary.v]
2022-10-05 removed redundant .lib data
    [adc_clkgen_with_edgedetect.sdf, metrics.csv]
2022-10-06 confirmation HDLL delay-cell is not slower than regular delay cell
    [delay_tb.sch]
2022-10-11 new resistance simulations
    [adc_gate_tb_resistance_01v8.sch, adc_gate_tb_resistance_g5v0.sch, adc_vcm_switch_tb_resistance.sch, adc_vcm_switch_tb_transient.sch]
2022-10-11 better simulation
    [adc_gate_tb_resistance_01v8.sch, adc_vcm_switch_tb_resistance.sch]
2022-10-12 gate switch calculations, lvt makes comparator faster at higher vcm
    [adc_comp_circuit.sch, adc_comp_circuit_tb.sch, adc_comp_latch_tb.sch, adc_gate_tb_resistance_01v8.sch, adc_gate_tb_resistance_g5v0.sch]
2022-10-13 Better switch work in progress saved
    [adc_gate_switch.sch, adc_gate_tb_bootstrap.sch, adc_gate_tb_resistance_01v8.sch, adc_gate_tb_resistance_g5v0.sch, adc_gate_tb_transient.sch]
2022-10-14 W=7.6 L=0.22 NF=4 with charge injection compensation fitted in gate
    [adc_gate_switch.sch, adc_gate_tb_resistance.sch]
2022-10-14 lvs clean, generate lef gds, update documentation
    [adc_array_circuit_gate.sch, adc_array_matrix_12bit.sch]
2022-10-14 new nonbinary LUT, nice verilog hdl with assign and conditional statements
    [nonbinary_code.xlsx]
2022-10-14 correct row col dimensions, better assignments
    [adc_control_nonbinary.v, adc_row_col_decoder.v, adc_row_col_decoder_tb.v]
2022-10-16 rename 6ns stdcell to 5ns and update adc_edge_detect verilog files, initial openlane hardened macro
    [adc_clkgen_with_edgedetect.sdf, metrics.csv, pin_order.cfg]
2022-10-17 added enable-pins in delay paths
    [adc_clkgen_with_edgedetect.sdf, metrics.csv, pin_order.cfg]
2022-10-17 fixed a loop error from the Dissertation, added validation testbench of generated macro
    [adc_clkgen_with_edgedetect.sdf, adc_clkgen_with_edgedetect_tb.sch, metrics.csv]
2022-10-18 implemented verilog naming convention _in _out _s _w
    [adc_clkgen_with_edgedetect.sdf, adc_clkgen_with_edgedetect_tb.sch, metrics.csv, pin_order.cfg]
2022-10-20 finished adc_clkgen_with_edgedetect function validation testbench
    [adc_clkgen_with_edgedetect.sdf, adc_clkgen_with_edgedetect_tb.sch, metrics.csv]
2022-10-20 discarded openlane projects
    [macro_placement.cfg, pin_order.cfg]
2022-10-25 first try of true mixed signal simulation
    [adc_array_matrix_12bit.sch, adc_array_wafflecap_8_1.sch, adc_array_wafflecap_8_2.sch, adc_array_wafflecap_8_4.sch, adc_array_wafflecap_8_8.sch, adc_array_wafflecap_8_drv.sch, adc_array_wafflecap_8_dummy.sch, adc_core_digital.sdf]
2022-10-25 renamed delay cell files to 5ns
    [sky130_mm_sc_hd_dlyPoly5ns.sch, sky130_mm_sc_hd_dlyPoly5ns_tb.sch]
2022-10-25 WORKING True-mixed-signal simulation, but digital OSR part needs a small fix
    [adc_array_matrix_12bit.sch, adc_clkgen_with_edgedetect_tb.sch, adc_top.sch, adc_top_tb.sch]
2022-10-25 mixed signal sim of clkloop
    [adc_top_tb.sch]
2022-10-26 fixed verilog files Result is now updated at end of loop instead of the beginning of next loop. OSR clock gating with cautious data-handling included, increased loop count by 1
    [adc_core_digital.sdf, adc_top_tb.sch, metrics.csv]
2022-10-26 adc_top schematic updated and better looking port orientation, clean folders
    [adc_top.sch, adc_top_tb.sch]
2022-10-26 sample delay added
2022-10-26 delay cells in matrix-sample-buffer added, gate-signal should be safely deasserted before sample-signal is changed
    [adc_clkgen_with_edgedetect.sdf, adc_clkgen_with_edgedetect_tb.sch, metrics.csv]
2022-10-27 Sim of adc_top finalized calculation of value in .spice simulation fixed "clock gating" fixed conv_finished signal fixed archive moved to common folder spice folders moved to origins
    [Threshold voltages compared.xlsx, adc_array_cap_16.sch, adc_array_circuit_180n.sch, adc_array_circuit_gate_sizing_tb.sch, adc_clkgen_with_edgedetect.sdf, adc_clkgen_with_edgedetect_tb.sch, adc_cm_clkgen.sch, adc_cm_clkgen_transient.sch]
2022-10-27 add plot vdiff
    [adc_top_tb.sch]
2022-10-28 pin order update
2022-10-28 work in progress adc_top_openlane
    [macro_placement.cfg, metrics.csv, pin_order.cfg]
2022-10-28 less heigth
    [adc_clkgen_with_edgedetect.sdf, metrics.csv]
2022-10-29 work in progress - core hardening
    [macro_placement.cfg]
2022-10-29 save work in progress - core hardening
    [adc_array_matrix_12bit.sch, adc_comp_circuit.sch, adc_comp_latch.sch, adc_vcm_generator.sch, macro_placement.cfg, pin_order.cfg]
2022-10-30 work in progress - hardening core
    [macro_placement.cfg]
2022-10-31 lvs pass, DRC fail (decap cell)
    [macro_placement.cfg, pin_order.cfg]
2022-11-22 rebuild macros, revert to VDD and VSS power names
    [adc_clkgen_with_edgedetect.sdf, metrics.csv]
2022-11-23 layout thru openlane, todo add vcm conenction manually
    [macro_placement.cfg]
2022-11-24 postlayout sim preparation
    [adc_top_postlayout_tb.sch]
2022-11-24 postlayout spice from flat gds, but huge
    [adc_top_postlayout_tb.sch, adc_vcm_generator_tb.sch]
2022-11-28 fix LVS
    [adc_array_matrix_12bit.sch, adc_array_wafflecap_8_1.sch, adc_array_wafflecap_8_2.sch, adc_array_wafflecap_8_4.sch, adc_array_wafflecap_8_8.sch, adc_array_wafflecap_8_drv.sch, adc_comp_latch.sch, adc_vcm_generator.sch]
2022-12-05 add xyce option, add spice files
    [adc_top_postlayout_tb.sch]
2022-12-07 update testbench, generate spice files
    [adc_top_postlayout_tb.sch]
2022-12-09 waveforms in schematic, data of successfull simulation added
    [adc_top_postlayout_tb.sch]
2022-12-10 load waveform command fixed
    [adc_top_postlayout_tb.sch]
2022-12-11 add internal signals as ports for simulation, allows to force internal VCM voltage for faster simulation
    [adc_top_postlayout_tb.sch]
2022-12-11 Change VGND to VSS
    [adc_top_tb.sch]
2022-12-11 fast testbench for single conversion
    [adc_top_postlayout_tb_conv.sch]
2022-12-11 add missing sample-signals at bincaps
    [adc_array_matrix_12bit.sch, adc_top_postlayout_tb_conv.sch, adc_top_tb.sch]
2022-12-11 extract adc_top spice-file with labels, add print statement in testbench for matrix row rowon col binen
    [adc_top_postlayout_tb_conv.sch]
2022-12-12 add adc_top sim data and waveforms
    [adc_top_tb.sch]
2022-12-12 fix klayout DRC errors in custom standardcell
    [sky130_mm_sc_hd_dlyPoly5ns.sch, sky130_mm_sc_hd_dlyPoly5ns_tb.sch]
2022-12-13 updated adc_top conversion simulation result
    [adc_top_postlayout_tb_conv.sch]
2022-12-13 corrected small error in waveform viewer of matrix-bus signals
    [adc_top_postlayout_tb_conv.sch]
2022-12-13 fixed a mistake where C0 enable is inverted
    [adc_row_col_decoder.v]
2022-12-18 redesign of ADC-Matrix, added dif changed .mag and .sch .sym files. Interchanged ROW and COL in ADC Wafflecap symbols. Add differential parasitic structures to assure constant number of HIGH and LOW 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
    [adc_array_circuit_1.sch, adc_array_circuit_2.sch, adc_array_circuit_4.sch, adc_array_circuit_8.sch, adc_array_circuit_drv.sch, adc_array_circuit_gate.sch, adc_array_matrix_12bit.sch, adc_array_wafflecap_8_1.sch]
2022-12-19 update Matrix mag files, update simulations, add matrix simulation for CTOP transfer-function
    [adc_row_col_decoder_tb.sch, adc_top.sch]
2022-12-20 pre-set cap matrix control signals of first value at init phase
    [adc_top_tb.sch]
2022-12-20 move matrix connectors up to met3
2022-12-20 generate new adc_top with redesigned matrix
    [macro_placement.cfg]
2022-12-22 update doc and sim
    [adc_top_postlayout_tb_conv.sch]
2022-12-22 matrix issue solved but simulation is semi-good, investigate clock tree synthesis
    [adc_top_tb.sch]
2022-12-22 Run Clock Tree Synthesis with arbitrary clock input, manually connect clock dig from Macro with digital clock, generate new GDS and Spice files for simulation
    [pin_order.cfg]
2022-12-29 updated powerup simulation results
    [adc_top_postlayout_tb.sch]
2023-01-12 added adc-matrix mixed mode switching scheme to verilog. Added control signals row_mode and col_mode. Added second conversion_finished signal additionally to conversion_osr_finished
    [adc_row_col_decoder_tb.sch, adc_top.sch, adc_top_tb.sch]
2023-01-13 updated simulation results of new rowcoldecoder, updated mixed signal sim doc
    [adc_row_col_decoder_tb.sch, adc_top_tb.sch]
2023-01-14 updated comparator layout for better input stage matching. Added dummy fets, more symmetry in layout
    [adc_comp_buffer.sch, adc_comp_circuit.sch, adc_comp_latch.sch]
2023-01-15 changed wiring for symmetry
2023-01-16 change synth strategy to AREA 1 - flow completes but is slower, TBD harden on working environment and evaluate further. Change OpenLane folder structure, remove double files by using relative paths i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
    [pin_order.cfg]
2023-01-17 OpenLane flow completes fast and without errors with synth strategy DELAY 4
2023-01-17 Fix weird routing around the cap matrix, macro cgen aligned
    [macro_placement.cfg, pin_order.cfg]
2023-01-17 patch pin order again, now no weird routing around macros
    [pin_order.cfg]
2023-01-17 postprocessing. Add vcm bridge, clk_dig wire, remove clk_dig_dummy, magic and klayout drc clean
2023-01-18 fix silly error in adc_top.v regarding conv_finished output wiring. Also optimize config.json
    [adc_top_postlayout_tb_conv.sch, macro_placement.cfg]
2023-01-19 update simulation results
    [adc_top_postlayout_tb.sch]
2023-01-19 further improvements: Buffer matrix inputs by adding explicit buffers in the gatelevel netlist
    [pin_order.cfg]
2023-01-19 add uic statement, skip DC OP calculation, faster transient start
    [adc_top_postlayout_tb.sch, adc_top_postlayout_tb_conv.sch]
2023-01-20 Add IIC JKU logo, add health bar chip-graffiti. Change design choices for safer operation: add gate-switch buffers to the gate-level verilog file adc_top.v, increase matrix-sample delays and re-harde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
2023-01-20 new simulation data for rowcoldecoder and adc conversion, also compress raw data
    [adc_row_col_decoder_tb.sch, adc_top_postlayout_tb_conv.sch]
2023-01-20 match inp inn pin position
2023-02-03 less data, linear timestep
    [adc_row_col_decoder_tb.sch]
2023-02-05 updated capacitor values to latest findings
2023-03-06 fix SAR algorithm to redundant mode, was falsely implemented as binary algorithm
    [adc_control_nonbinary.v, adc_control_nonbinary_tb.v, adc_core_digital_tb.v]
2023-03-07 update OpenLane project for fixed SAR algorithm, added obstruction macros
    [macro_placement.cfg, pin_order.cfg]
2023-03-08 updated simulation results testbench top conversion
    [adc_top_postlayout_tb_conv.sch]
2023-03-17 fix typo in top-level testbench plot
    [adc_top_tb.sch]
2023-03-19 set the DAC matrix default value 2048 one clock cycle before the sample switch, this prevents pumping charge from the conversion into the VCM capacitors
    [adc_control_nonbinary.v, adc_core_digital_tb.v]
2023-03-19 update build script, flow completes with recent changes
2023-03-20 layout generated with change of SAR code before sampling
    [adc_top_postlayout_tb.sch]
2023-03-21 align macro to stdcell routing grid
    [macro_placement.cfg]
2023-03-22 test with changed matrix sample switch generation
    [adc_top_postlayout_tb.sch, pin_order.cfg]
2023-03-23 removed power rails
2023-03-23 better sample signal wiring
2023-03-23 change DAC driver cell to single-mode input, because it was possible that the DAC decoder T-gates did not turn off simultaneously, therefore a low impedance path between VDRV and VCM was possible. TH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
    [adc_array_circuit_drv.sch]
2023-03-23 DAC drive cell with complementary clock generation circuit (Razavi Design o. Analog CMOS IC 2nd ed. Fig. 13.19)
    [adc_array_circuit_drv.sch]
2023-03-23 updated testbench, 4 cycles with osr and averaging
    [adc_top_postlayout_tb.sch]
2023-03-24 exchange buffer in sample matrix signal path
2023-03-24 added sample signal label, added sample signal plot script
    [adc_top_postlayout_tb.sch]
2023-03-25 simulation results, 4-osr 3-avg 4 samples
2023-04-03 Add power dissipation
2023-04-14 NMOS capacitor change, NMOS embedded in pwell (inversion) is now in nwell (accumulation). These varactors are better HF capacitors than NMOS in PWELL
    [adc_noise_decoup_cell1.sch, adc_noise_decoup_cell2.sch]
2023-06-07 Use new `lvs_ignore` property of `xschem` to get LVS passing
    [adc_array_wafflecap_8_1.sch, adc_array_wafflecap_8_2.sch, adc_array_wafflecap_8_4.sch, adc_array_wafflecap_8_8.sch]
